pi-radio/FR3-Control/FR3-1ch-Datasheet/sections/sec0_summary_rx.tex

% Generated by FR3_Characterization/make_summary_table.py -- do not edit by hand.
\begin{tabularx}{\summarywidth}{|l|X|ccc|l|c|}
\hline
\textbf{Parameter} & \textbf{Condition} & \textbf{Min} & \textbf{Typ} & \textbf{Max} & \textbf{Unit} & \textbf{Sec.} \\
\hline
\multicolumn{7}{|l|}{\textit{Conversion gain and flatness}} \\
\hline
Conversion gain & low-side LO, filter optimal & 27.5 & 37.2 & 53.0 & dB & \ref{sec:rx-gain-lowside} \\
Conversion gain & low-side LO, filter bypassed & 37.7 & 45.9 & 56.9 & dB & \ref{sec:rx-gain-lowside} \\
Conversion gain & high-side LO, filter optimal & 27.2 & 39.6 & 51.2 & dB & \ref{sec:rx-gain-highside} \\
Conversion gain & high-side LO, filter bypassed & 36.7 & 46.0 & 57.5 & dB & \ref{sec:rx-gain-highside} \\
Gain flatness (RMS) & low-side LO, filter optimal & 0.39 & 0.95 & 2.24 & dB & \ref{sec:rx-flatness} \\
Gain flatness (RMS) & low-side LO, filter bypassed & 0.46 & 1.03 & 2.63 & dB & \ref{sec:rx-flatness} \\
Gain flatness (RMS) & high-side LO, filter optimal & 0.38 & 0.90 & 3.19 & dB & \ref{sec:rx-flatness} \\
Gain flatness (RMS) & high-side LO, filter bypassed & 0.37 & 0.95 & 2.89 & dB & \ref{sec:rx-flatness} \\
\hline
\multicolumn{7}{|l|}{\textit{Compression}} \\
\hline
Input P1dB & low-side LO, 8 test points & −32.6 & −23.9 & −12.3 & dBm & \ref{sec:rx-compression-lowside} \\
Output P1dB & low-side LO, 8 test points & 13.2 & 14.3 & 18.4 & dBm & \ref{sec:rx-compression-lowside} \\
Input P1dB & high-side LO, 9 test points & −28.3 & −23.2 & −13.7 & dBm & \ref{sec:rx-compression-highside} \\
Output P1dB & high-side LO, 9 test points & 13.2 & 14.5 & 18.3 & dBm & \ref{sec:rx-compression-highside} \\
\hline
\multicolumn{7}{|l|}{\textit{Image rejection}} \\
\hline
Image rejection & low-side LO, filter optimal & 24\raisebox{0.55ex}{\scriptsize a} & 51 &  & dB & \ref{sec:rx-image-rejection} \\
Image rejection & high-side LO, filter optimal & 17\raisebox{0.55ex}{\scriptsize a} & 35 &  & dB & \ref{sec:rx-image-rejection} \\
\hline
\multicolumn{7}{|l|}{\textit{Noise figure and sensitivity}} \\
\hline
Noise figure (SSB) & low-side LO, filter optimal & 5.2 & 12.2 & 22.9 & dB & \ref{sec:rx-noise-figure} \\
Noise figure (SSB) & high-side LO, filter optimal & 5.6 & 11.0 & 20.5 & dB & \ref{sec:rx-noise-figure} \\
Noise floor at RF input & median NF, filter optimal, 100\,MHz bandwidth &  & −82.5 &  & dBm & \ref{sec:rx-noise-figure} \\
\hline
\multicolumn{7}{|l|}{\textit{Spurious outputs}} \\
\hline
LO leakage at RF input & LO 7--22.5\,GHz, TX LO nulled\raisebox{0.55ex}{\scriptsize d} &  & −59.6 & −49.3 & dBm & \ref{sec:spur-rx-lo} \\
2×LO leakage at RF input & LO 7--13.2\,GHz, TX LO nulled\raisebox{0.55ex}{\scriptsize d} &  & −71.1 & −58.8 & dBm & \ref{sec:spur-rx-lo} \\
\hline
\end{tabularx}
