pi-radio/FR3-Control/FR3-1ch-Datasheet/sections/sec0_summary_tx.tex

% Generated by FR3_Characterization/make_summary_table.py -- do not edit by hand.
\begin{tabularx}{\summarywidth}{|l|X|ccc|l|c|}
\hline
\textbf{Parameter} & \textbf{Condition} & \textbf{Min} & \textbf{Typ} & \textbf{Max} & \textbf{Unit} & \textbf{Sec.} \\
\hline
\multicolumn{7}{|l|}{\textit{Conversion gain and flatness}} \\
\hline
Conversion gain & upper sideband, filter optimal & 18.1 & 28.1 & 43.7 & dB & \ref{sec:tx-gain-upper} \\
Conversion gain & upper sideband, filter bypassed & 27.2 & 36.0 & 48.6 & dB & \ref{sec:tx-gain-upper} \\
Conversion gain & lower sideband, filter optimal & 17.0 & 30.8 & 41.9 & dB & \ref{sec:tx-gain-lower} \\
Conversion gain & lower sideband, filter bypassed & 29.5 & 37.1 & 49.3 & dB & \ref{sec:tx-gain-lower} \\
Gain flatness (RMS) & upper sideband, filter optimal & 0.17 & 1.51 & 3.29 & dB & \ref{sec:tx-flatness} \\
Gain flatness (RMS) & upper sideband, filter bypassed & 0.20 & 1.55 & 3.63 & dB & \ref{sec:tx-flatness} \\
Gain flatness (RMS) & lower sideband, filter optimal & 0.16 & 1.26 & 3.07 & dB & \ref{sec:tx-flatness} \\
Gain flatness (RMS) & lower sideband, filter bypassed & 0.19 & 1.21 & 2.74 & dB & \ref{sec:tx-flatness} \\
\hline
\multicolumn{7}{|l|}{\textit{Compression}} \\
\hline
Output P1dB & upper sideband, 9 test points & 8.1 & 17.1 & 18.2 & dBm & \ref{sec:compression-upper} \\
Input P1dB & upper sideband, 9 test points & −24.3 & −13.2 & −7.0 & dBm & \ref{sec:compression-upper} \\
Output P1dB & lower sideband, 9 test points & 4.9 & 15.8 & 18.4 & dBm & \ref{sec:compression-lower} \\
Input P1dB & lower sideband, 9 test points & −21.1 & −11.5 & −5.6 & dBm & \ref{sec:compression-lower} \\
\hline
\multicolumn{7}{|l|}{\textit{Sideband suppression}} \\
\hline
Sideband suppression & upper desired, filter optimal & 40\raisebox{0.55ex}{\scriptsize a} & 52 &  & dB & \ref{sec:sideband-suppression} \\
Sideband suppression & upper desired, filter bypassed & 8\raisebox{0.55ex}{\scriptsize a} & 15 &  & dB & \ref{sec:sideband-suppression} \\
Sideband suppression & lower desired, filter optimal & 37\raisebox{0.55ex}{\scriptsize a} & 49 &  & dB & \ref{sec:sideband-suppression} \\
Sideband suppression & lower desired, filter bypassed & 11\raisebox{0.55ex}{\scriptsize a} & 17 &  & dB & \ref{sec:sideband-suppression} \\
\hline
\multicolumn{7}{|l|}{\textit{LO leakage}} \\
\hline
LO leakage, other filter settings & calibrated, hot (LMX 79--85\,\textdegree C) &  & −30\raisebox{0.55ex}{\scriptsize b} & −11 & dBm & \ref{sec:lo-suppression} \\
LO leakage below −20\,dBm & calibrated, hot, all (LO, filter) readings &  & 90.4 &  & \% & \ref{sec:lo-suppression} \\
\hline
\multicolumn{7}{|l|}{\textit{Spurious outputs}} \\
\hline
2×LO spur & LO 7--13.2\,GHz, all filter settings, no input\raisebox{0.55ex}{\scriptsize c} &  & −38.7 & −12.3 & dBm & \ref{sec:spur-tx-2lo} \\
\hline
\end{tabularx}
