pi-radio/FR3-Control/FR3-1ch-Datasheet/main.tex

\documentclass{tufte-handout}

% ---------- Font: IBM Plex Sans throughout (matches the project's matplotlib figures) ----------
\usepackage{fontspec}
\setmainfont{IBMPlexSans}[
  Path = fonts/,
  Extension = .ttf,
  UprightFont = *-Regular,
  BoldFont = *-SemiBold,
  ItalicFont = *-Italic,
]
\setsansfont{IBMPlexSans}[
  Path = fonts/,
  Extension = .ttf,
  UprightFont = *-Regular,
  BoldFont = *-SemiBold,
  ItalicFont = *-Italic,
]

\usepackage{graphicx}
\usepackage{booktabs}
\usepackage{tabularx}
\usepackage[bottom]{footmisc}  % footnotes stay at the foot of the page even where \raggedbottom is used (the RX Noise Figure section)
\usepackage{capt-of}   % \captionof{figure}{...} -- real, numbered captions outside of float placement,
                       % needed for the dense multi-up figure grids below
\usepackage{eso-pic}   % draws the logo at an absolute page position, bypassing fancyhdr/geometry's header
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
  \@afterindentfalse\@afterheading
}
\makeatother

% ---------- Page footer: page number centered at the bottom, on every page (the logo, below, is handled
% completely separately via eso-pic, not through this header/footer mechanism). ----------
\pagestyle{fancy}
\fancyhf{}
\renewcommand{\headrulewidth}{0pt}
\renewcommand{\footrulewidth}{0pt}
\fancyfoot[C]{\footnotesize Page \thepage}
\AtBeginDocument{\fancyhfoffset[RE,RO,LE,LO]{0pt}}

% ---------- Pi-Radio logo, top-right corner, equally inset from both the top and right physical page
% edges, identical size and position on every single page (including the title page) -- drawn directly at
% an absolute position via eso-pic, completely bypassing fancyhdr/geometry's header-band math (which,
% unlike a simple margin, does not place header content a uniform distance from the physical page edge). ----------
\newlength{\logosize}
\setlength{\logosize}{0.45in}
\newlength{\logoinset}
\setlength{\logoinset}{0.05in}
\AddToShipoutPictureFG{%
  \AtPageLowerLeft{%
    \put(\LenToUnit{\dimexpr \paperwidth-\logoinset-\logosize\relax},%
         \LenToUnit{\dimexpr \paperheight-\logoinset-\logosize\relax}){%
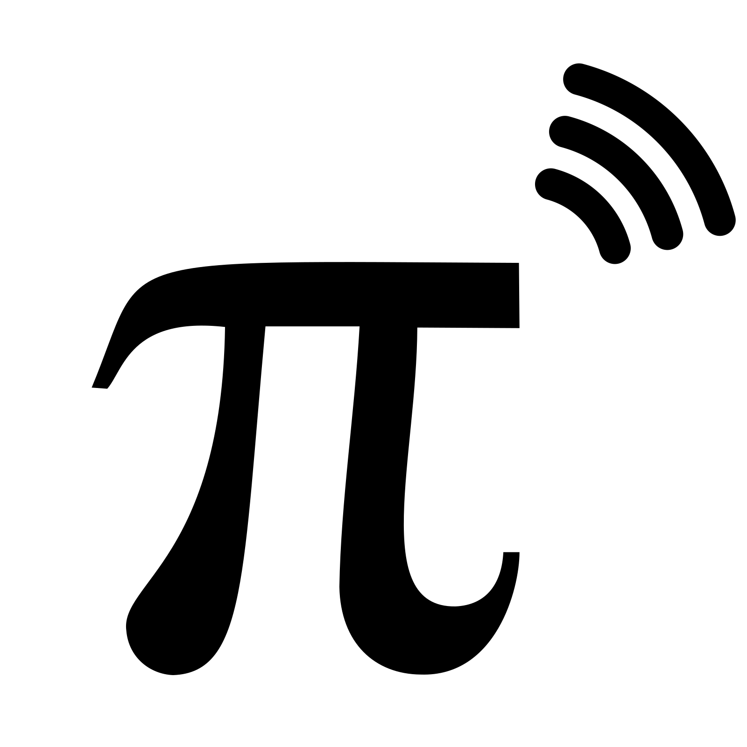
[picture p3: FR3-1ch-Datasheet/images/pi-radio-logo.png]
      %
    }%
  }%
}

% ---------- "Contents" heading in bold. ----------
\renewcommand{\contentsname}{\bfseries Contents}

% ---------- Dense figure grids: two images per row, real numbered captions via \captionof, no float
% placement algorithm involved. ----------
\newcommand{\figpair}[6]{%
  \noindent
  \begin{minipage}[t]{0.485\linewidth}
    \centering
    
    \captionof{figure}{#2}\label{#3}
  \end{minipage}\hfill
  \begin{minipage}[t]{0.485\linewidth}
    \centering
    
    \captionof{figure}{#5}\label{#6}
  \end{minipage}
  \par\vspace{1.5em}
}

% A single, larger figure (used sparingly, for a figure meant to stand out on its own, e.g. a full-grid
% heatmap or summary plot).
\newcommand{\figone}[3]{%
  \begin{center}
  
  \captionof{figure}{#2}\label{#3}
  \end{center}
  \vspace{0.5em}
}

% A single figure on its own row, at a fixed, consistent width -- used for pairs of "hero" figures (e.g.
% two full-grid heatmaps) that each get their own row so they can be larger than \figpair panels, while
% still matching each other's size exactly.
\newcommand{\figrow}[3]{%
  \begin{center}
  
  \captionof{figure}{#2}\label{#3}
  \end{center}
  \vspace{0.8em}
}

% A single figure at the SAME size as one \figpair panel (used for an odd-one-out figure that is part of
% the same series as the others, e.g. figure 9 of 9 near-identical panels, and should not look enlarged).
\newcommand{\figonesmall}[3]{%
  \noindent
  \begin{minipage}[t]{0.485\linewidth}
    \centering
    
    \captionof{figure}{#2}\label{#3}
  \end{minipage}
  \par\vspace{1.5em}
}

% A single figure at the same size as one \figpair panel, with its caption to the RIGHT instead of below (saves a row's
% height, e.g. so the 9th panel of a series fits on the page with the others).
\newcommand{\figsidecap}[3]{%
  \noindent
  \begin{minipage}[c]{0.485\linewidth}
    \centering
    
  \end{minipage}\hfill
  \begin{minipage}[c]{0.485\linewidth}
    \captionof{figure}{#2}\label{#3}
  \end{minipage}
  \par\vspace{1.0em}
}

\title{Pi-Radio FR3-1ch Front-end Kit Datasheet}
\author{}
\date{}

% ---------- \keepnext{<height>}: start a new page here unless at least <height> is left on this one, so a short
% paragraph is never split with a single line at the foot of a page (same logic as the needspace package). ----------
\makeatletter
\newcommand{\keepnext}[1]{\par\penalty-100\begingroup\setlength{\dimen@}{#1}%
  \dimen@ii\pagegoal\advance\dimen@ii-\pagetotal
  \ifdim\dimen@>\dimen@ii\ifdim\dimen@ii>\z@\vfil\fi\break\fi\endgroup}
\makeatother

\begin{document}
\maketitle
\unmarkedfootnote{Note: Testing performed on Unit \#5.}

\tableofcontents

% Author's Note: boxed, pinned to the bottom-right corner of page 1 (overlay: takes no space from the contents list)
\begin{tikzpicture}[remember picture, overlay]
\node[anchor=south east, draw=black!45, fill=black!4, inner sep=6pt, text width=0.42\textwidth, font=\small,
  align=left] at ([xshift=-\oddsidemargin-1in-\hoffset+\textwidth, yshift=2.6cm]current page.south west)
  {\textbf{Author's Note.} This document is written as both a tutorial and a datasheet. Every result in it is measured
   on real hardware, and each one is explained along the way: what is being measured, how, and why it matters.
   Students new to RF systems can read it to learn the ideas; engineers can go straight to the numbers.};
\end{tikzpicture}
\clearpage

\input{sections/section_summary}
\input{sections/section0_hardware_primer}
\input{sections/section1_tx_gain_upper}
\input{sections/section2_tx_gain_lower}
\input{sections/section_tx_flatness}
\input{sections/section3_sideband_suppression}
\input{sections/section4_compression_upper}
\input{sections/section5_compression_lower}
\input{sections/section6_lo_suppression}
\input{sections/section_spurious_outputs}
\input{sections/section7_rx_gain_lowside}
\input{sections/section8_rx_gain_highside}
\input{sections/section_rx_flatness}
\input{sections/section9_rx_compression_lowside}
\input{sections/section10_rx_compression_highside}
\input{sections/section11_rx_image_rejection}
\input{sections/section12_rx_noise_figure}
\input{sections/section13_phase_noise}
\input{sections/section14_tips}
\input{sections/appendix_gui}
\input{sections/appendix_commands}
\input{sections/appendix_setup}

\end{document}
