pi-radio/FR3-Control/FR3-1ch-Datasheet/sections/sec14_table.tex

% Generated by FR3_Characterization/plot_datasheet_pn.py -- do not edit by hand.
\begin{tabular}{|l|ccccc|c|}
\hline
\textbf{LO} & \textbf{100\,Hz} & \textbf{1\,kHz} & \textbf{10\,kHz} & \textbf{100\,kHz} & \textbf{1\,MHz} & \textbf{RMS phase error} \\
 & \multicolumn{5}{c|}{(dBc/Hz)} & (degrees) \\
\hline
8\,GHz & −63.9 & −85.4 & −88.4 & −97.3 & −123.7 & 0.82 \\
10\,GHz & −62.3 & −83.3 & −86.5 & −95.1 & −122.1 & 1.02 \\
12\,GHz & −60.6 & −81.8 & −85.0 & −93.2 & −119.3 & 1.25 \\
14\,GHz & −58.4 & −80.9 & −83.8 & −92.0 & −118.2 & 1.46 \\
16\,GHz & −58.0 & −79.2 & −82.5 & −91.1 & −118.5 & 1.63 \\
18\,GHz & −57.4 & −78.1 & −82.0 & −90.2 & −116.9 & 1.80 \\
20\,GHz & −55.2 & −77.1 & −80.2 & −89.2 & −116.0 & 2.06 \\
22\,GHz & −55.4 & −76.5 & −80.2 & −89.3 & −117.2 & 2.13 \\
\hline
\end{tabular}
