pi-radio/FR3-Control/FR3-1ch-Datasheet/sections/sec6_cal_numbers.tex

% generated by FR3_Characterization/make_sec6_cal_numbers.py -- do not edit
% hot: results\unit_005\2026-10-09\lo_cal_grid_100MHz_20261009_022928_full_cal_hot_drive_rule_table.csv
% cold: results\unit_005\2026-10-09\lo_cal_grid_100MHz_20261009_112919_full_cal_cold_drive_rule_table.csv
\providecommand{\attn}[1]{\textcolor{red}{\textbf{#1}}}
\providecommand{\ph}[1]{\textcolor{red}{\textbf{[#1]}}}
\newcommand{\calLoCount}{156}
\newcommand{\calReadCount}{1591}
\newcommand{\calThreshold}{−20}
\newcommand{\calPassPct}{85}
\newcommand{\calColdMinC}{57}
\newcommand{\calColdMaxC}{63}
\newcommand{\calHotMinC}{79}
\newcommand{\calHotMaxC}{85}
\newcommand{\calColdPct}{88.9}
\newcommand{\calHotPct}{90.4}
\newcommand{\calColdMedian}{−29}
\newcommand{\calHotMedian}{−30}
\newcommand{\calColdWorst}{−10}
\newcommand{\calHotWorst}{−11}
\newcommand{\calRefMedian}{−65}
\newcommand{\calMinutesPerTemp}{57}
