pi-radio/FR3-Control/FR3-1ch-Datasheet/sections/sec_image_numbers.tex

% generated by FR3_Characterization/plot_datasheet_image.py from image_rx_20261009 -- do not edit
\newcommand{\imgLowBypassMedian}{−1}
\newcommand{\imgLowBypassPten}{−4}
\newcommand{\imgLowBypassMin}{−6}
\newcommand{\imgLowBypassCount}{209}
\newcommand{\imgOutlierAX}{0.6962}
\newcommand{\imgOutlierAY}{0.3328}
\newcommand{\imgOutlierBX}{0.8057}
\newcommand{\imgOutlierBY}{0.3857}
\newcommand{\imgLowOptimalMedian}{51}
\newcommand{\imgLowOptimalPten}{24}
\newcommand{\imgLowOptimalMin}{0}
\newcommand{\imgLowOptimalCount}{209}
\newcommand{\imgHighBypassMedian}{1}
\newcommand{\imgHighBypassPten}{−2}
\newcommand{\imgHighBypassMin}{−6}
\newcommand{\imgHighBypassCount}{203}
\newcommand{\imgHighOptimalMedian}{35}
\newcommand{\imgHighOptimalPten}{17}
\newcommand{\imgHighOptimalMin}{3}
\newcommand{\imgHighOptimalCount}{203}
