pi-radio/FR3-Control/FR3-1ch-Datasheet/sections/sec_spur_numbers.tex

% generated by FR3_Characterization/plot_datasheet_spurs.py -- do not edit
\newcommand{\spurCount}{50}
\newcommand{\spurLoMin}{7}
\newcommand{\spurLoMax}{13.125}
\newcommand{\spurLoStepMHz}{125}
\newcommand{\spurTwoLoMin}{14}
\newcommand{\spurTwoLoMax}{26.25}
\newcommand{\spurTwoLoLimit}{26.5}
\newcommand{\spurLoLimit}{13.25}
\newcommand{\spurMax}{−22.5}
\newcommand{\spurMaxLo}{8.125}
\newcommand{\spurMaxTwoLo}{16.25}
\newcommand{\spurMedian}{−32.9}
\newcommand{\spurMin}{−49.8}
\newcommand{\spurMinLo}{10.875}
\newcommand{\spurMinTwoLo}{21.75}
\newcommand{\spurExpected}{−20}
\newcommand{\spurLmxMinC}{58}
\newcommand{\spurLmxMaxC}{71}
\newcommand{\spurToneCount}{25}
\newcommand{\spurToneWithinOne}{21}
\newcommand{\spurToneMedianDiff}{0.4}
\newcommand{\spurAmpLow}{−14.7}
\newcommand{\spurAmpHigh}{−10.8}
\newcommand{\spurZeroBiasWorst}{−13.2}
\newcommand{\spurZeroBiasLoMax}{10}
\newcommand{\rxLeakLoCount}{156}
\newcommand{\rxLeakLoMin}{7}
\newcommand{\rxLeakLoMax}{−49.3}
\newcommand{\rxLeakLoMedian}{−59.6}
\newcommand{\rxLeakLoMaxAt}{17.1}
\newcommand{\rxLeakLoBest}{−85.2}
\newcommand{\rxLeakTwoLoCount}{63}
\newcommand{\rxLeakTwoLoMax}{−58.8}
\newcommand{\rxLeakTwoLoMedian}{−71.1}
\newcommand{\rxLeakTwoLoMaxAt}{13.2}
\newcommand{\rxLeakLoFineMax}{13.2}
\newcommand{\rxLeakLmxMinC}{77}
\newcommand{\rxLeakLmxMaxC}{84}
\newcommand{\rxLeakLoTop}{22.5}
\newcommand{\rxLeakLoBestAt}{7}
\newcommand{\rxLeakOffsetMv}{5}
\newcommand{\rxLeakOffsetCount}{4}
\newcommand{\rxLeakOffsetMaxChange}{0.3}
\newcommand{\rxLeakOffsetLos}{8, 12, 16, 20}
