pi-radio/FR3-Control/FR3-1ch-Datasheet/images/gui_shot_helper.png

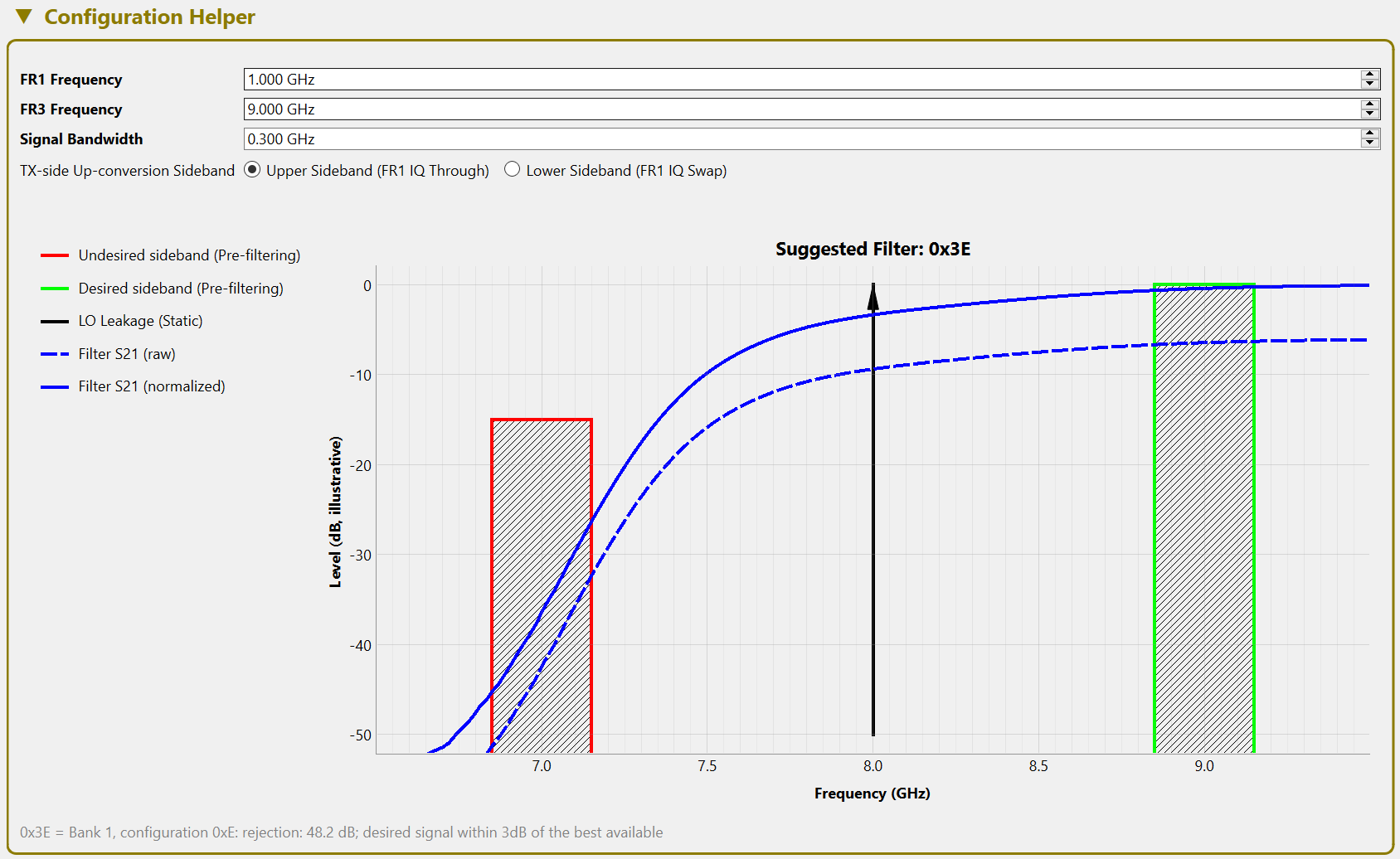
FR3-1ch-Datasheet/images/gui_shot_helper.png
