pi-radio/FR3-Control/FR3-1ch-Datasheet/images/gui_shot_rx.png

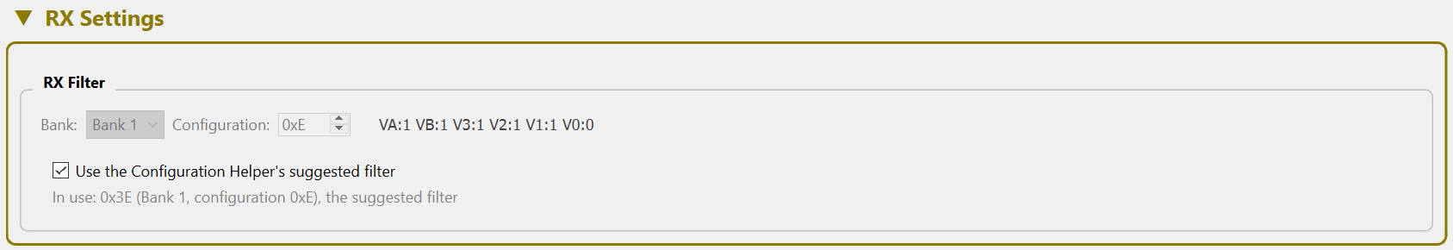
FR3-1ch-Datasheet/images/gui_shot_rx.png
