pi-radio/FR3-Control/FR3_Characterization/results/unit_005/2026-10-07/lo_cal_grid_100MHz_20261007_185015_one_null_per_LO_states.csv

lo_ghz | tx_filter | band | model_s21_at_lo_db | is_reference | lo_dbm_ref_bias
7.0 | 0x30 | band 1 | -8.1 | 0 | -21.09
7.0 | 0x3B | band 1 | -8.0 | 1 | -61.3
7.0 | 0x3C | band 1 | -8.4 | 0 | -36.68
7.0 | 0x3D | band 1 | -11.2 | 0 | -33.88
7.0 | 0x3E | band 1 | -42.4 | 0 | -40.09
7.1 | 0x30 | band 1 | -8.3 | 0 | -20.63
7.1 | 0x3B | band 1 | -7.8 | 1 | -61.69
7.1 | 0x3C | band 1 | -8.1 | 0 | -34.34
7.1 | 0x3D | band 1 | -10.3 | 0 | -32.08
7.1 | 0x3E | band 1 | -35.7 | 0 | -41.48
7.2 | 0x30 | band 1 | -8.4 | 0 | -17.63
7.2 | 0x3B | band 1 | -7.6 | 1 | -61.9
7.2 | 0x3C | band 1 | -7.8 | 0 | -29.59
7.2 | 0x3D | band 1 | -9.6 | 0 | -27.58
7.2 | 0x3E | band 1 | -29.2 | 0 | -42.43
7.3 | 0x30 | band 1 | -8.6 | 1 | -72.87
7.3 | 0x3D | band 1 | -9.1 | 0 | -16.02
7.3 | 0x3E | band 1 | -23.6 | 0 | -31.93
7.4 | 0x30 | band 1 | -8.8 | 0 | -16.1
7.4 | 0x3D | band 1 | -8.7 | 1 | -70.57
7.4 | 0x3E | band 1 | -19.1 | 0 | -41.53
7.5 | 0x30 | band 1 | -9.0 | 0 | -16.33
7.5 | 0x3D | band 1 | -8.3 | 1 | -63.7
7.5 | 0x3E | band 1 | -15.8 | 0 | -35.2
7.6 | 0x30 | band 1 | -9.4 | 0 | -18.35
7.6 | 0x3D | band 1 | -8.0 | 1 | -61.37
7.6 | 0x3E | band 1 | -13.5 | 0 | -31.82
7.7 | 0x30 | band 1 | -9.8 | 0 | -21.23
7.7 | 0x3D | band 1 | -7.7 | 1 | -68.49
7.7 | 0x3E | band 1 | -11.9 | 0 | -30.48
7.8 | 0x10 | band 2 | -64.9 | 0 | -42.74
7.8 | 0x30 | band 1 | -10.3 | 0 | -23.78
7.8 | 0x3D | band 1 | -7.4 | 1 | -55.69
7.8 | 0x3E | band 1 | -10.8 | 0 | -33.88
7.9 | 0x10 | band 2 | -64.1 | 0 | -44.59
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
22.2 | 0x24 | band 3 | -21.6 | 0 | -29.92
22.2 | 0x25 | band 3 | -19.3 | 0 | -25.04
22.2 | 0x28 | band 3 | -17.2 | 0 | -21.61
22.2 | 0x2F | band 3 | -16.7 | 1 | -52.67
22.3 | 0x1E | band 2 | -50.5 | 0 | -26.09
22.3 | 0x1F | band 2 | -46.2 | 0 | -27.49
22.3 | 0x20 | band 3 | -32.7 | 0 | -26.26
22.3 | 0x21 | band 3 | -29.2 | 0 | -27.73
22.3 | 0x22 | band 3 | -25.9 | 0 | -30.05
22.3 | 0x24 | band 3 | -22.3 | 0 | -30.84
22.3 | 0x25 | band 3 | -19.9 | 0 | -25.08
22.3 | 0x28 | band 3 | -17.7 | 0 | -21.39
22.3 | 0x2F | band 3 | -15.9 | 1 | -69.23
22.4 | 0x1F | band 2 | -46.5 | 0 | -24.56
22.4 | 0x20 | band 3 | -33.8 | 0 | -26.55
22.4 | 0x21 | band 3 | -30.2 | 0 | -27.98
22.4 | 0x22 | band 3 | -26.9 | 0 | -30.83
22.4 | 0x24 | band 3 | -23.1 | 0 | -32.71
22.4 | 0x25 | band 3 | -20.4 | 0 | -26.09
22.4 | 0x28 | band 3 | -18.2 | 0 | -21.83
22.4 | 0x2F | band 3 | -15.2 | 1 | -62.06
22.5 | 0x1F | band 2 | -47.5 | 0 | -22.69
22.5 | 0x20 | band 3 | -34.7 | 0 | -24.56
22.5 | 0x21 | band 3 | -31.3 | 0 | -25.52
22.5 | 0x22 | band 3 | -27.9 | 0 | -27.88
22.5 | 0x24 | band 3 | -24.0 | 0 | -31.51
22.5 | 0x25 | band 3 | -21.1 | 0 | -26.1
22.5 | 0x27 | band 3 | -16.9 | 0 | -17.35
22.5 | 0x28 | band 3 | -18.7 | 0 | -21.28
22.5 | 0x2F | band 3 | -14.5 | 1 | -67.43
