pi-radio/FR3-Control/FR3_Characterization/results/unit_005/2026-10-07/lo_cal_grid_20MHz_20261007_200815_one_null_per_LO_20MHz_states.csv

lo_ghz | tx_filter | band | model_s21_at_lo_db | is_reference | lo_dbm_ref_bias
7.0 | 0x30 | band 1 | -8.1 | 0 | -21.16
7.0 | 0x3B | band 1 | -8.0 | 1 | -59.61
7.0 | 0x3C | band 1 | -8.4 | 0 | -36.59
7.0 | 0x3D | band 1 | -11.2 | 0 | -33.88
7.0 | 0x3E | band 1 | -42.4 | 0 | -40.37
7.02 | 0x30 | band 1 | -8.2 | 0 | -21.47
7.02 | 0x3B | band 1 | -8.0 | 1 | -63.43
7.02 | 0x3C | band 1 | -8.3 | 0 | -35.3
7.02 | 0x3D | band 1 | -11.0 | 0 | -33.43
7.02 | 0x3E | band 1 | -41.1 | 0 | -40.35
7.04 | 0x30 | band 1 | -8.2 | 0 | -21.1
7.04 | 0x3B | band 1 | -7.9 | 1 | -56.19
7.04 | 0x3C | band 1 | -8.3 | 0 | -36.53
7.04 | 0x3D | band 1 | -10.8 | 0 | -33.8
7.04 | 0x3E | band 1 | -39.9 | 0 | -40.52
7.06 | 0x30 | band 1 | -8.2 | 0 | -21.08
7.06 | 0x3B | band 1 | -7.9 | 1 | -65.04
7.06 | 0x3C | band 1 | -8.2 | 0 | -34.68
7.06 | 0x3D | band 1 | -10.6 | 0 | -33.02
7.06 | 0x3E | band 1 | -38.5 | 0 | -40.67
7.08 | 0x30 | band 1 | -8.2 | 0 | -20.95
7.08 | 0x3B | band 1 | -7.8 | 1 | -81.35
7.08 | 0x3C | band 1 | -8.1 | 0 | -34.53
7.08 | 0x3D | band 1 | -10.5 | 0 | -32.88
7.08 | 0x3E | band 1 | -37.1 | 0 | -41.15
7.1 | 0x30 | band 1 | -8.3 | 0 | -20.79
7.1 | 0x3B | band 1 | -7.8 | 1 | -55.31
7.1 | 0x3C | band 1 | -8.1 | 0 | -34.1
7.1 | 0x3D | band 1 | -10.3 | 0 | -32.64
7.1 | 0x3E | band 1 | -35.7 | 0 | -41.71
7.12 | 0x30 | band 1 | -8.3 | 0 | -20.42
7.12 | 0x3B | band 1 | -7.7 | 1 | -59.7
7.12 | 0x3C | band 1 | -8.0 | 0 | -33.38
7.12 | 0x3D | band 1 | -10.1 | 0 | -31.93
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
12.44 | 0x3D | band 1 | -18.4 | 0 | -21.21
12.44 | 0x3E | band 1 | -12.1 | 0 | -17.0
12.46 | 0x19 | band 2 | -10.9 | 1 | -68.24
12.46 | 0x1C | band 2 | -15.0 | 0 | -21.88
12.46 | 0x1D | band 2 | -24.0 | 0 | -23.08
12.46 | 0x1E | band 2 | -40.8 | 0 | -24.73
12.46 | 0x3C | band 1 | -28.4 | 0 | -24.32
12.46 | 0x3D | band 1 | -18.7 | 0 | -21.2
12.46 | 0x3E | band 1 | -12.2 | 0 | -17.08
12.48 | 0x19 | band 2 | -10.9 | 1 | -77.79
12.48 | 0x1C | band 2 | -14.8 | 0 | -21.79
12.48 | 0x1D | band 2 | -23.6 | 0 | -22.87
12.48 | 0x1E | band 2 | -40.6 | 0 | -24.58
12.48 | 0x3C | band 1 | -28.8 | 0 | -24.16
12.48 | 0x3D | band 1 | -19.0 | 0 | -21.37
12.48 | 0x3E | band 1 | -12.4 | 0 | -17.19
12.5 | 0x19 | band 2 | -10.8 | 1 | -94.17
12.5 | 0x1C | band 2 | -14.7 | 0 | -21.78
12.5 | 0x1D | band 2 | -23.2 | 0 | -22.7
12.5 | 0x1E | band 2 | -40.3 | 0 | -24.58
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
