pi-radio/FR3-Control/FR3_Characterization/calibration/fr1_cable_s21_20260923_172433.csv

freq_hz | s21_db | s21_phase_deg | s21_re | s21_im
500000000 | -0.37460 | -57.9425 | 0.50836620 | -0.81174175
502000000 | -0.37556 | -59.6236 | 0.48427924 | -0.82621461
504000000 | -0.37798 | -61.2902 | 0.45991822 | -0.83971553
506000000 | -0.37908 | -62.9347 | 0.43557501 | -0.85246094
508000000 | -0.37890 | -64.5982 | 0.41065271 | -0.86476355
510000000 | -0.37729 | -66.2787 | 0.38518753 | -0.87659710
512000000 | -0.38125 | -67.9658 | 0.35905012 | -0.88715323
514000000 | -0.38034 | -69.6274 | 0.33320884 | -0.89728536
516000000 | -0.37923 | -71.2824 | 0.30719432 | -0.90665031
518000000 | -0.37841 | -72.9747 | 0.28031264 | -0.91541310
520000000 | -0.38003 | -74.6130 | 0.25397813 | -0.92288132
522000000 | -0.38208 | -76.2799 | 0.22697146 | -0.92965916
524000000 | -0.38316 | -77.9616 | 0.19956589 | -0.93580282
526000000 | -0.38332 | -79.5982 | 0.17275484 | -0.94110396
528000000 | -0.38327 | -81.2871 | 0.14494495 | -0.94579188
530000000 | -0.38667 | -82.9629 | 0.11717759 | -0.94925429
532000000 | -0.38454 | -84.6227 | 0.08965531 | -0.95248341
534000000 | -0.38329 | -86.2752 | 0.06215901 | -0.95481049
536000000 | -0.38221 | -87.9432 | 0.03434480 | -0.95633390
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
