pi-radio/FR3-Control/FR3_Characterization/calibration/fr3_cable_s21_20260923_172214.csv

freq_hz | s21_db | s21_phase_deg | s21_re | s21_im
2000000000 | -0.51687 | -95.5919 | -0.09181264 | -0.93774512
2012250000 | -0.51712 | -102.8106 | -0.20891409 | -0.91874879
2024500000 | -0.51363 | -109.9991 | -0.32236743 | -0.88574084
2036750000 | -0.51107 | -117.1680 | -0.43051043 | -0.83883440
2049000000 | -0.51018 | -124.3278 | -0.53175786 | -0.77871614
2061250000 | -0.50940 | -131.5066 | -0.62495864 | -0.70622297
2073500000 | -0.51206 | -138.7718 | -0.70903384 | -0.62132943
2085750000 | -0.51449 | -145.9667 | -0.78105040 | -0.52748675
2098000000 | -0.51018 | -153.2206 | -0.84182184 | -0.42485426
2110250000 | -0.51624 | -160.3740 | -0.88755468 | -0.31649741
2122500000 | -0.51773 | -167.5748 | -0.92006827 | -0.20271487
2134750000 | -0.52055 | -174.8417 | -0.93801615 | -0.08467733
2147000000 | -0.52431 | 177.9519 | -0.94082066 | 0.03364491
2159250000 | -0.53315 | 170.7610 | -0.92826400 | 0.15099465
2171500000 | -0.53417 | 163.5595 | -0.90190673 | 0.26613838
2183750000 | -0.54100 | 156.3841 | -0.86092410 | 0.37641233
2196000000 | -0.54098 | 149.2062 | -0.80714530 | 0.48103671
2208250000 | -0.54650 | 142.0112 | -0.74007138 | 0.57797412
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
