pi-radio/FR3-Control/FR3_Characterization/results/external_lo/octolo_lo10GHz_20261004_163029.csv

offset_hz | trace1_dbc_hz | trace2_dbc_hz
100.0 | -82.14 | -82.86
101.5469 | -82.7 | -82.82
103.1177 | -83.77 | -82.75
104.7129 | -82.59 | -82.77
106.3327 | -83.25 | -82.8
107.9775 | -83.06 | -82.85
109.6478 | -83.42 | -82.99
111.344 | -81.84 | -83.17
113.0663 | -81.92 | -83.37
114.8154 | -83.17 | -83.55
116.5914 | -83.05 | -83.78
118.395 | -82.54 | -84.04
120.2264 | -83.03 | -84.25
122.0862 | -83.96 | -84.37
123.9748 | -83.48 | -84.49
125.8925 | -84.04 | -84.66
127.84 | -86.18 | -84.84
129.8175 | -86.57 | -85.0
131.8257 | -86.25 | -85.18
133.8649 | -86.01 | -85.49
135.9356 | -85.38 | -85.81
138.0384 | -87.05 | -86.07
140.1737 | -87.46 | -86.33
142.3421 | -87.05 | -86.59
144.544 | -85.51 | -86.86
146.7799 | -86.45 | -87.08
149.0505 | -86.55 | -87.36
151.3561 | -87.34 | -87.57
153.6975 | -86.73 | -87.73
156.075 | -87.69 | -87.89
158.4893 | -88.92 | -88.0
160.941 | -89.29 | -88.14
163.4306 | -89.19 | -88.39
165.9587 | -89.06 | -88.5
168.5259 | -88.31 | -88.55
171.1328 | -89.42 | -88.68
173.7801 | -88.99 | -88.89
176.4683 | -89.87 | -89.13
179.1981 | -88.87 | -89.34
181.9701 | -89.95 | -89.53
184.785 | -90.2 | -89.77
187.6434 | -88.68 | -89.97
190.5461 | -89.35 | -90.18
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
