pi-radio/FR3-Control/FR3_Characterization/results/unit_005/2026-10-07/lo_cal_grid_100MHz_20261007_185015_one_null_per_LO_table.csv

lo_ghz | ref_filter | ref_model_s21_db | ref_i_v | ref_q_v | null_search_dbm | ref_dbm_in_sweep | n_states | min_dbm | max_dbm | n_blocking | floor_dbm | lmx_temp_c | seconds
7.0 | 0x3B | -8.0 | 0.02956 | 0.03414 | -60.45 | -61.3 | 5 | -61.3 | -21.09 | 1 | -40.09 | 58.4 | 31.1
7.1 | 0x3B | -7.8 | 0.03712 | 0.04185 | -63.11 | -61.69 | 5 | -61.69 | -20.63 | 0 |  | 58.4 | 18.0
7.2 | 0x3B | -7.6 | 0.03117 | 0.05001 | -62.53 | -61.9 | 5 | -61.9 | -17.63 | 0 |  | 58.4 | 18.1
7.3 | 0x30 | -8.6 | 0.0214 | 0.0507 | -62.03 | -72.87 | 3 | -72.87 | -16.02 | 0 |  | 57.6 | 16.5
7.4 | 0x3D | -8.7 | 0.01194 | 0.04757 | -68.1 | -70.57 | 3 | -70.57 | -16.1 | 0 |  | 57.6 | 16.5
7.5 | 0x3D | -8.3 | 0.01347 | 0.04536 | -63.07 | -63.7 | 3 | -63.7 | -16.33 | 0 |  | 57.6 | 16.5
7.6 | 0x3D | -8.0 | 0.01797 | 0.04795 | -57.97 | -61.37 | 3 | -61.37 | -18.35 | 0 |  | 57.6 | 16.8
7.7 | 0x3D | -7.7 | 0.0211 | 0.05077 | -59.78 | -68.49 | 3 | -68.49 | -21.23 | 0 |  | 57.6 | 16.6
7.8 | 0x3D | -7.4 | 0.02316 | 0.05375 | -62.14 | -55.69 | 4 | -55.69 | -23.78 | 1 | -42.74 | 56.8 | 17.4
7.9 | 0x3D | -7.2 | 0.02369 | 0.05978 | -62.66 | -61.62 | 6 | -61.62 | -25.69 | 3 | -44.59 | 57.6 | 18.6
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
