pi-radio/FR3-Control/FR3_Characterization/results/unit_005/2026-10-07/lo_cal_grid_20MHz_20261007_200815_one_null_per_LO_20MHz_table.csv

lo_ghz | ref_filter | ref_model_s21_db | ref_i_v | ref_q_v | null_search_dbm | ref_dbm_in_sweep | n_states | min_dbm | max_dbm | n_blocking | floor_dbm | lmx_temp_c | seconds
7.0 | 0x3B | -8.0 | 0.02911 | 0.03414 | -60.58 | -59.61 | 5 | -59.61 | -21.16 | 1 | -40.37 | 61.0 | 31.2
7.02 | 0x3B | -8.0 | 0.03147 | 0.03506 | -58.67 | -63.43 | 5 | -63.43 | -21.47 | 1 | -40.35 | 61.0 | 18.2
7.04 | 0x3B | -7.9 | 0.03353 | 0.03635 | -57.08 | -56.19 | 5 | -56.19 | -21.1 | 0 |  | 60.1 | 18.1
7.06 | 0x3B | -7.9 | 0.03491 | 0.03796 | -55.52 | -65.04 | 5 | -65.04 | -21.08 | 0 |  | 61.0 | 18.1
7.08 | 0x3B | -7.8 | 0.0359 | 0.03986 | -59.21 | -81.35 | 5 | -81.35 | -20.95 | 0 |  | 60.1 | 17.9
7.1 | 0x3B | -7.8 | 0.03643 | 0.04192 | -58.94 | -55.31 | 5 | -55.31 | -20.79 | 0 |  | 60.1 | 18.0
7.12 | 0x3B | -7.7 | 0.03651 | 0.04414 | -58.72 | -59.7 | 5 | -59.7 | -20.42 | 0 |  | 60.1 | 18.2
7.14 | 0x3B | -7.7 | 0.03597 | 0.04627 | -59.39 | -67.16 | 5 | -67.16 | -19.81 | 0 |  | 60.1 | 19.0
7.16 | 0x3B | -7.6 | 0.03491 | 0.04818 | -58.15 | -66.48 | 5 | -66.48 | -18.92 | 0 |  | 60.1 | 18.0
7.18 | 0x3B | -7.6 | 0.033 | 0.0494 | -66.42 | -55.03 | 5 | -55.03 | -18.41 | 0 |  | 60.1 | 18.0
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
