pi-radio/FR3-Control/FR3_Characterization/results/unit_005/2026-10-07/rx_port_leakage_20261007_171052_pass2_RXport_all_LOs.csv

lo_ghz | two_lo_ghz | tx_filter | rx_filter | i_v | q_v | lmx_power | lo_dbm | lo_floor_dbm | two_lo_dbm | two_lo_floor_dbm | lo_dbm_tx_offset | two_lo_dbm_tx_offset | lmx_temp_c
7.0 | 14.0 | 0x3D | 0x3D | 0.02911 | 0.03292 | 0 | -81.72 | -103.28 | -70.51 | -99.59 |  |  | 59.3
7.125 | 14.25 | 0x3E | 0x3E | 0.042 | 0.04032 | 0 | -80.03 | -103.22 | -68.15 | -98.79 |  |  | 58.4
7.25 | 14.5 | 0x3E | 0x3E | 0.02255 | 0.05787 | 0 | -78.34 | -102.38 | -66.94 | -98.79 |  |  | 58.4
7.375 | 14.75 | 0x3E | 0x3E | 0.01064 | 0.0478 | 0 | -78.75 | -101.65 | -67.69 | -98.21 |  |  | 57.6
7.5 | 15.0 | 0x3E | 0x3E | 0.01125 | 0.0452 | 0 | -76.7 | -103.53 | -67.14 | -98.8 |  |  | 57.6
7.625 | 15.25 | 0x3E | 0x3E | 0.01637 | 0.04879 | 0 | -75.41 | -103.75 | -65.91 | -99.21 |  |  | 57.6
7.75 | 15.5 | 0x3E | 0x3E | 0.01995 | 0.05123 | 0 | -71.29 | -103.83 | -64.15 | -98.77 |  |  | 57.6
7.875 | 15.75 | 0x3E | 0x3E | 0.02285 | 0.05673 | 0 | -72.11 | -103.96 | -63.16 | -97.78 |  |  | 57.6
8.0 | 16.0 | 0x3E | 0x3E | 0.02186 | 0.05856 | 0 | -71.3 | -102.81 | -61.45 | -98.44 | -71.42 | -61.49 | 57.6
8.125 | 16.25 | 0x3F | 0x3F | 0.01797 | 0.06046 | 0 | -73.03 | -101.87 | -60.39 | -98.1 |  |  | 57.6
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
