pi-radio/FR3-Control/FR3_1CH_Firmware/FR3_1CH_Firmware.ioc

Mcu.UserName=STM32H573VITx
PA0.GPIO_Label=BUCK_EN_5V3
PA0.Signal=GPIO_Output
PA1.GPIO_Label=BUCK_EN_3V7
PA1.Signal=GPIO_Output
PA11.Signal=USB_DM
PA12.Signal=USB_DP
PA13(JTMS/SWDIO).Signal=DEBUG_JTMS-SWDIO
PA14(JTCK/SWCLK).Signal=DEBUG_JTCK-SWCLK
PA2.GPIO_Label=TEST_POINT_1
PA2.Signal=GPIO_Output
PA3.GPIO_Label=TEST_POINT_2
PA3.Signal=GPIO_Output
PB13.Signal=UCPD1_CC1
PB14.Signal=UCPD1_CC2
PB4(NJTRST).GPIO_Label=RXFILT_VA
PB4(NJTRST).Signal=GPIO_Output
PB5.GPIO_Label=RXFILT_VB
PB5.Signal=GPIO_Output
PB6.GPIO_Label=RXFILT_V0
PB6.Signal=GPIO_Output
PB7.GPIO_Label=RXFILT_V1
PB7.Signal=GPIO_Output
PB8.GPIO_Label=RXFILT_V2
PB8.Signal=GPIO_Output
PB9.GPIO_Label=RXFILT_V3
PB9.Signal=GPIO_Output
PC7.GPIO_Label=TCXO_EN_3V3
PC7.Signal=GPIO_Output
PC8.GPIO_Label=SPI_INA_CSb
PC8.Signal=GPIO_Output
PD10.GPIO_Label=TXFILT_V2
PD10.Signal=GPIO_Output
PD11.GPIO_Label=TXFILT_V1
PD11.Signal=GPIO_Output
PD12.GPIO_Label=TXFILT_V0
PD12.Signal=GPIO_Output
PD13.GPIO_Label=TXFILT_VB
PD13.Signal=GPIO_Output
PD14.GPIO_Label=TXFILT_VA
PD14.Signal=GPIO_Output
PD8.GPIO_Label=INRUSH_EN
PD8.Signal=GPIO_Output
PD9.GPIO_Label=TXFILT_V3
PD9.Signal=GPIO_Output
PE10.GPIO_Label=CSb_LTC2668_3V3
PE10.Signal=GPIO_Output
PE12.GPIO_Label=IQ_SWAP_SW_3V3
PE12.Signal=GPIO_Output
PE13.GPIO_Label=CLK_SEL
PE13.Signal=GPIO_Output
PE2.Signal=SPI4_SCK
PE5.Signal=SPI4_MISO
PE6.Signal=SPI4_MOSI
PE8.GPIO_Label=LO_CTRL_3V3
PE8.Signal=GPIO_Output
PE9.GPIO_Label=CSb_LMX_3V3
PE9.Signal=GPIO_Output
