pi-radio/FR3-Control/FR3_Characterization/lo_soak.py

"""Soak: watch the LO leakage and the LMX temperature over time at the board's CURRENT configuration. Changes nothing.

    python lo_soak.py [--seconds 300] [--name lo_soak_<time>]

The board is only read (GET PERSIST first, then LMX/I/Q/temperature queries): no voltage, LO or PERSIST setting is written, and
no session snapshot/restore is used (a restore could re-tune the LMX). The FieldFox analyzer is used exactly as it was left by
the last nulling run (span, attenuation, reference level, RBW/VBW, averaging): nothing is configured, the marker is just read,
once per second, from the analyzer's running average. Only if the tone drifts to the edge of the span is the center re-tuned
(logged). Cable loss is subtracted to give the level at the board's RF connector.

Writes results/unit_<serial>/<name>/soak.csv (t_s, lo_leakage_dbm_at_board, lmx_temp_c, tone_offset_hz, lmx_lock), and two PNGs:
LO leakage vs. time, and LMX temperature vs. time."""

from __future__ import annotations

import argparse
import csv
import json
import os
import sys
import time
from datetime import datetime

import matplotlib
import numpy as np

matplotlib.use("Agg")
import matplotlib.pyplot as plt  # noqa: E402

from board import OPERATING_TIMEOUT_S, Board, find_board_ports
from cables import CableLoss
from fieldfox import SETTLE_S, FieldFox
from plot_power_sweep import BLUE, INK, INK2, MUTED, ORANGE, SURFACE, style_axes
from results_layout import unit_dir
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
