pi-radio/FR3-Control/(commit log)

2026-09-14 Add ARM64 Linux build; document Linux setup gotchas
    Description (long field):
    - Add ubuntu-22.04-arm CI target producing FR3-Board-Control-Linux-arm64
    (for Jetson-class ARM boards), alongside the renamed
    FR3-Board-Control-Linux-x86_64 (same job as before, just renamed now
    that there are two Linux variants)
    - Document three Linux setup issues found testing on a real ARM64
    (Jetson) machine: a broken venv when python3-venv isn't installed,
    missing libxcb-cursor0 for Qt6, and /dev/ttyACM0 permission denied
    without dialout group membership
    - Cross-link the two runtime gotchas (libxcb-cursor0, dialout) from the
    main README
2026-09-15 Add LMX2820 temperature display; rework LO source configuration
    Firmware:
    - Enable the LMX2820's internal temperature sensor (R19 TEMPSENSE_EN)
    and add LMX2820_GetTemperatureC() via R76's rb_TEMP_SENS readback
    (0.85*code-415, +/-5C per TI datasheet). New `LMX TEMP?` serial
    command.
    - `LMX LOCK?` now reports UNLOCKED instead of INVALID for the
    LMX2820's rb_LD=0b11 state (e.g. seen with External clock selected
    and nothing connected) - not actionable any differently, so no need
    to expose it as a distinct third state.
    - Fix a -Wformat-truncation warning in the new FormatFixed1() helper.
    GUI:
    - Display live LMX2820 die temperature next to lock status.
    - Configuration Helper redesign: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
2026-09-15 Idiot-proof Configuration Helper's LO/filter validation; new app icon
    Configuration Helper (FR1/FR3/sideband -> LMX2820 LO):
    - Enforce a stricter 7.0GHz GUI floor on the required LO frequency
    (LMX2820 hardware itself still accepts 6.0GHz via LMX TUNE directly).
    - FR3's own input range now has a 5.5GHz floor.
    - FR1/FR3 arrow-button/key steps now apply and validate immediately,
    while typing still waits for Enter/focus-loss - previously, arrow
    steps silently skipped both the retune and the out-of-range check
    (new SteppedDoubleSpinBox in widgets.py distinguishes the two).
    - An invalid FR1/FR3/sideband combination is now fully rejected: FR1
    and FR3 snap back to the last valid combinatio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
2026-09-15 Warn when local FR1/FR3 recipe doesn't match the device's actual LO
    FR1/FR3/bandwidth are a per-machine local convenience (local_settings.py)
    - unlike every other value in the LMX section, they're never read back
    from the device itself. If a board is moved between machines (or a
    different local settings file), those boxes could silently disagree
    with the LMX2820's actual last-tuned frequency, risking an unexpected
    LO jump if the user then nudges either field.
    - New ConfigurationHelper.check_recipe_matches_device(), called once
    after the board's snapshot arrives: compares the locally-cached
    FR1/FR3/sideband's implied LO against the LMX2820's real last-tuned
    frequency (only when Interna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
2026-09-15 Fix intermittent LMX2820 boot lock failure; default clock to Internal
    - lmx2820.c: LMX2820_Tune()'s cold-boot path (RESET toggle + 500ms
    settle + full 123-register write + lock poll) now retries up to 3
    times before giving up, instead of a single attempt. The chip's own
    cold-boot calibration is documented as attempt-count-dependent
    (attempt #1 sometimes fails, #2 locks), and the automatic boot-time
    restore had no way to recover from an unlucky first attempt with no
    user around to retune manually. Confirmed this was the cause of
    intermittent UNLOCKED-after-reconnect behavior, notably through a
    USB hub that power-cycles its downstream port on every host-side
    reconne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
2026-09-16 Fix USB CDC-ACM enumeration failures from ThreadX/UCPD regeneration
    Traced and fixed four independent bugs preventing the CDC-ACM COM port
    from enumerating at all, found via debugger call-stack/register
    inspection on the rev 1.1 board:
    - UX_APP_MEM_POOL_SIZE / USBX_MEMORY_STACK_SIZE / UX_DEVICE_APP_THREAD_
    STACK_SIZE (app_azure_rtos_config.h, app_usbx.h, app_usbx_device.h)
    were reset to CubeMX's generic 1024-byte defaults by the UCPD1
    code regeneration. Two back-to-back allocations from a 1024-byte
    ThreadX byte pool exhausted it immediately, hanging the device in
    tx_application_define()'s error trap before USB hardware was ever
    touched. Raised to 24576 / 16384 / 4096 respectivel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
2026-09-17 Add full USB-PD sink negotiation; fix recurring CubeMX regen regressions
    Replaced the simple CC-current-tier-only sink (usb_pd_sink.c) with ST's
    full STM32_USBPD_Library middleware (Sink role, PD3 Full Stack, single
    5V/1.5A PDO) to support real USB-PD contract negotiation with modern
    PD-only sources (laptops, PD-capable hubs/chargers) that refuse to apply
    any VBUS at all without one - confirmed necessary via extensive real-
    hardware testing, since simple Type-C current advertisement alone left
    those sources permanently unpowered.
    - New Middlewares/ST/STM32_USBPD_Library tree, Src/Inc usbpd*.c/.h files,
    and GPDMA1 config (gpdma.c/.h) for the UCPD1 RX/TX DMA channels the
    middleware requir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
2026-09-18 Add INA229 power monitor support; fix recurring CubeMX regen regressions
    Added ina229.c/.h: a driver for the rev 1.4-only INA229 board power/current
    monitor, sharing SPI4 with the LMX2820 and LTC2668. Write-only from
    firmware's perspective - the INA229's SDO runs at 5V0 (its VS pin is tied
    to USB_VBUS) and would have driven 5V onto the shared 3.3V MISO net, so a
    series resistor near the chip was depopulated on the PCB to permanently
    isolate its SDO. That rules out any register readback (VBUS, current,
    alarm status via SPI), leaving only boot-time configuration and clearing
    alarms.
    - Calibrated for a 1.7A max expected board current (20mOhm shunt,
    ADCRANGE=1 for better resolution at our ove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
2026-09-18 Split GUI build script into per-platform variants; add Linux launch script
    Renamed build.bat to build_windows.bat (its content is unchanged) now
    that there are per-platform siblings alongside it:
    - build_linux_arm64.sh: same PyInstaller rebuild as build_windows.bat, for
    Linux ARM64 (Jetson-class boards). Assumes the venv already exists at
    FR3_GUI/venv, per PACKAGING.md's setup instructions - same assumption
    build_windows.bat makes on Windows.
    - launch_linux_arm64.sh: runs main.py directly from source via the venv's
    Python, for quick iteration on a Jetson without a full PyInstaller
    rebuild each time.
    Both new .sh files need `chmod +x` after pulling on Linux, since the
    executable b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
2026-10-10 FR3-1ch datasheet r1, measurement scripts, firmware/GUI 1.4.1 LO cal
    Datasheet (FR3-1ch-Datasheet) - first revision, Unit #5, firmware 1.4.1
    - 19 sections + 4 appendices: Key Specs, Hardware Primer, TX gain/flatness/
    sideband/compression/LO suppression, spurious outputs, RX gain/flatness/
    compression/image rejection/NF and sensitivity, phase noise, usage tips,
    GUI guide (screenshots with numbered callouts), command reference,
    measurement setup, revision history.
    - All measurements hot (no fan, LMX2820 die ~70-85 C), LMX drive rule by LO.
    - Numbers come from generated .tex macro files; figures from the plot scripts.
    - tools/: GUI screenshot cropping and off-screen GUI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
