pi-radio/FR3-Control/(notices)

Notices in the files:
FR3_1CH_Firmware/Inc/main.h:
Copyright (c) 2026 STMicroelectronics.
All rights reserved.
This software is licensed under terms that can be found in the LICENSE file
